emanuel-eckstein/HydroIntellix/Bilder/Platine_verloetet.jpg

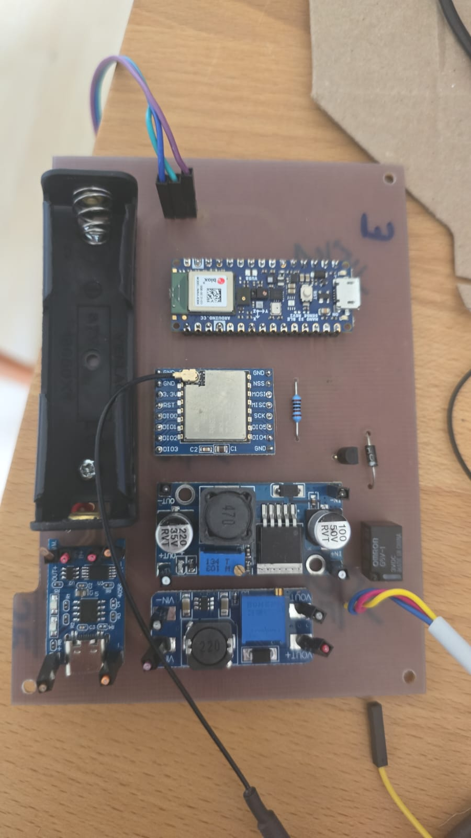
Bilder/Platine_verloetet.jpg
