emanuel-eckstein/HydroIntellix/Bilder/HydroIntellix_im_Erdbeerbeet.jpg

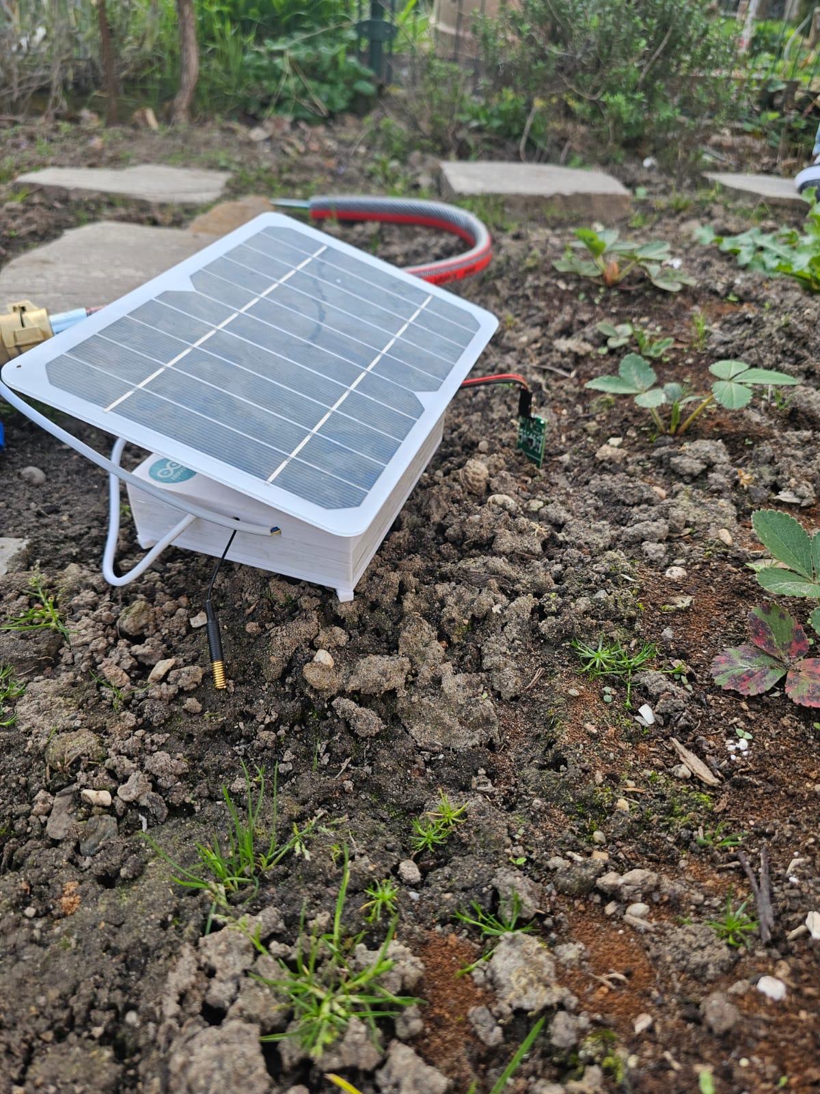
Bilder/HydroIntellix_im_Erdbeerbeet.jpg
