emanuel-eckstein/HydroIntellix/Werkzeugliste.txt

Werkzeugliste

Lötkolben, Dritte Hand, Entlötpumpe, Lötzinn
Zange
Hobby/Cutter-Messer
Multimeter (Spannungs und Widerstandsprüfung)
3D-Drucker
Steckbrückenkabel
Telefonzange
Schraubenzieherset
Dremel (bohren und flexen)
Abisolierzange

optional:
DC Voltage supply
Schrumpfschläuche
