emanuel-eckstein/HydroIntellix/Bilder/HydroIntellix_im_Rasen.jpg

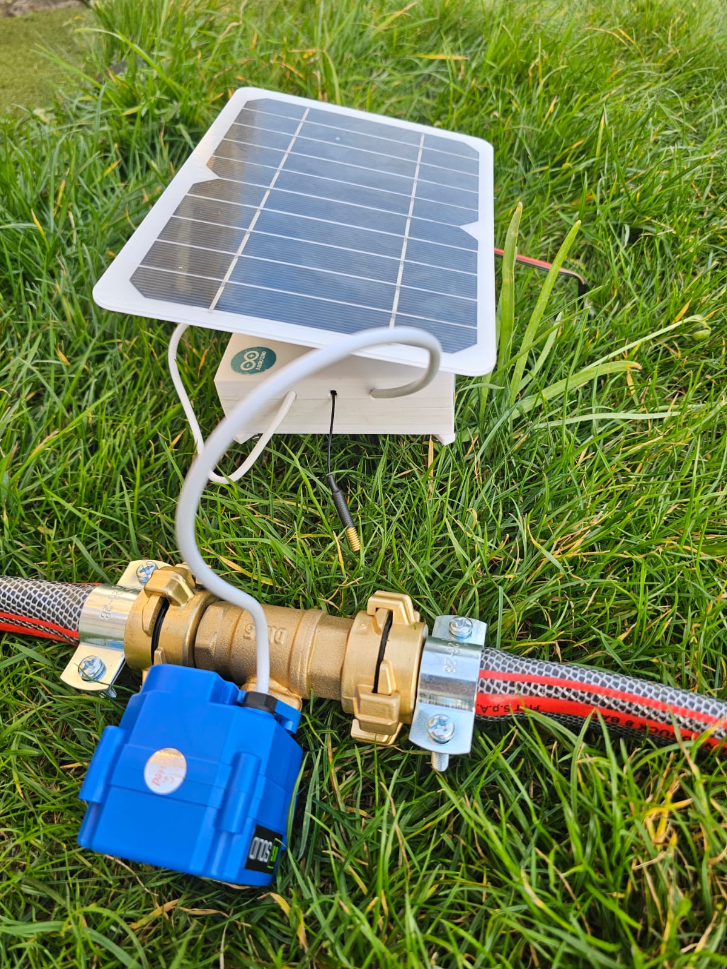
Bilder/HydroIntellix_im_Rasen.jpg
