emanuel-eckstein/HydroIntellix/Leiterplatten/Leiterplatteneditor.png

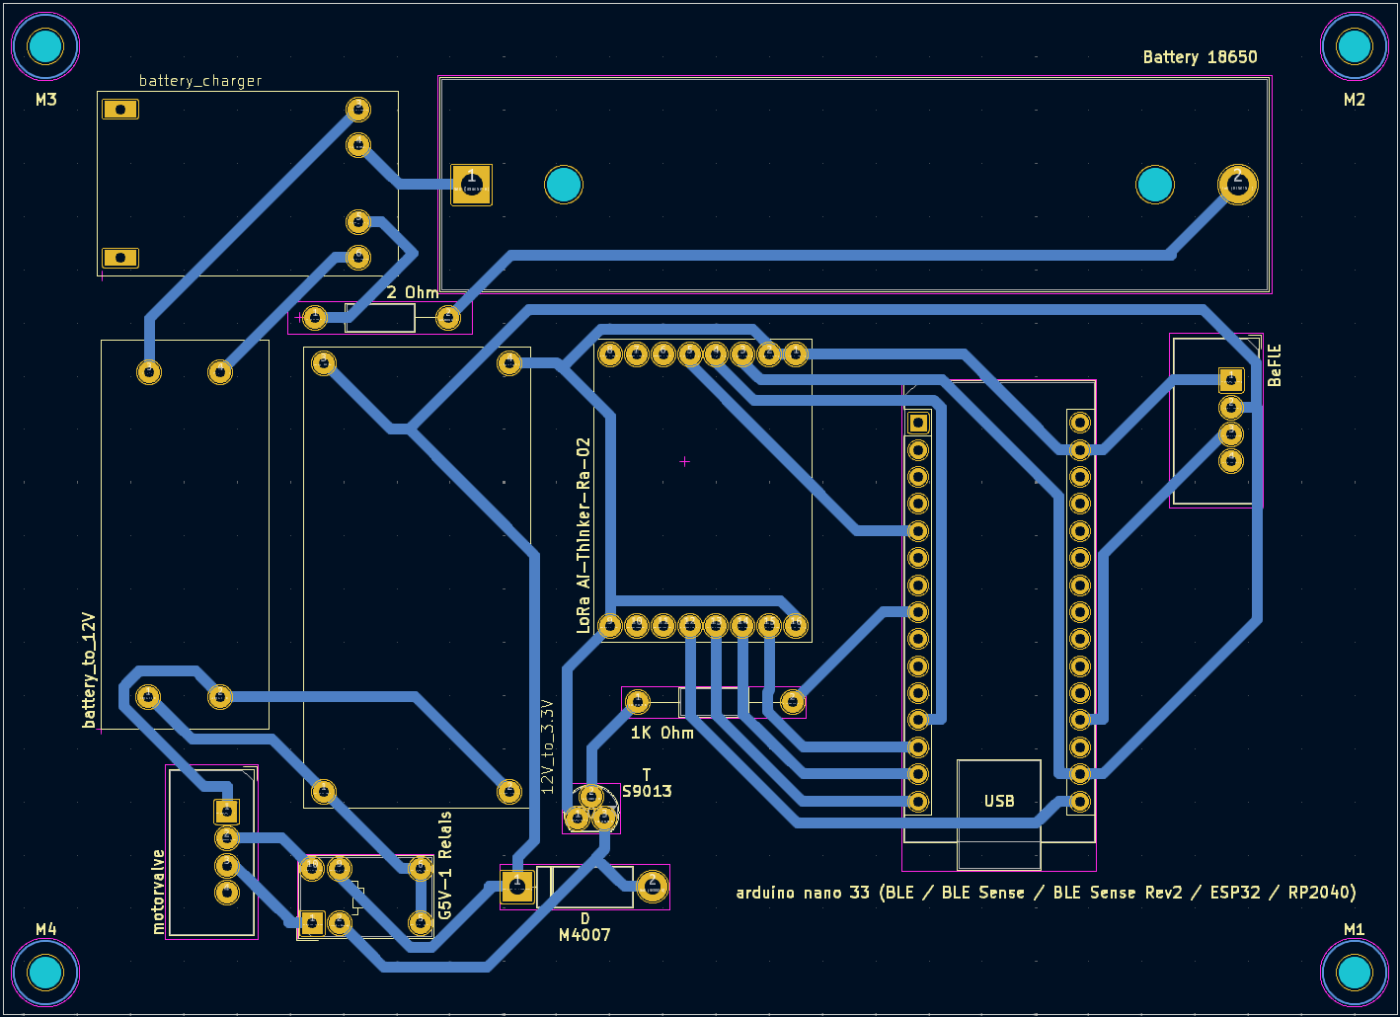
Leiterplatten/Leiterplatteneditor.png
