emanuel-eckstein/HydroIntellix/Leiterplatten/Schaltplan.png

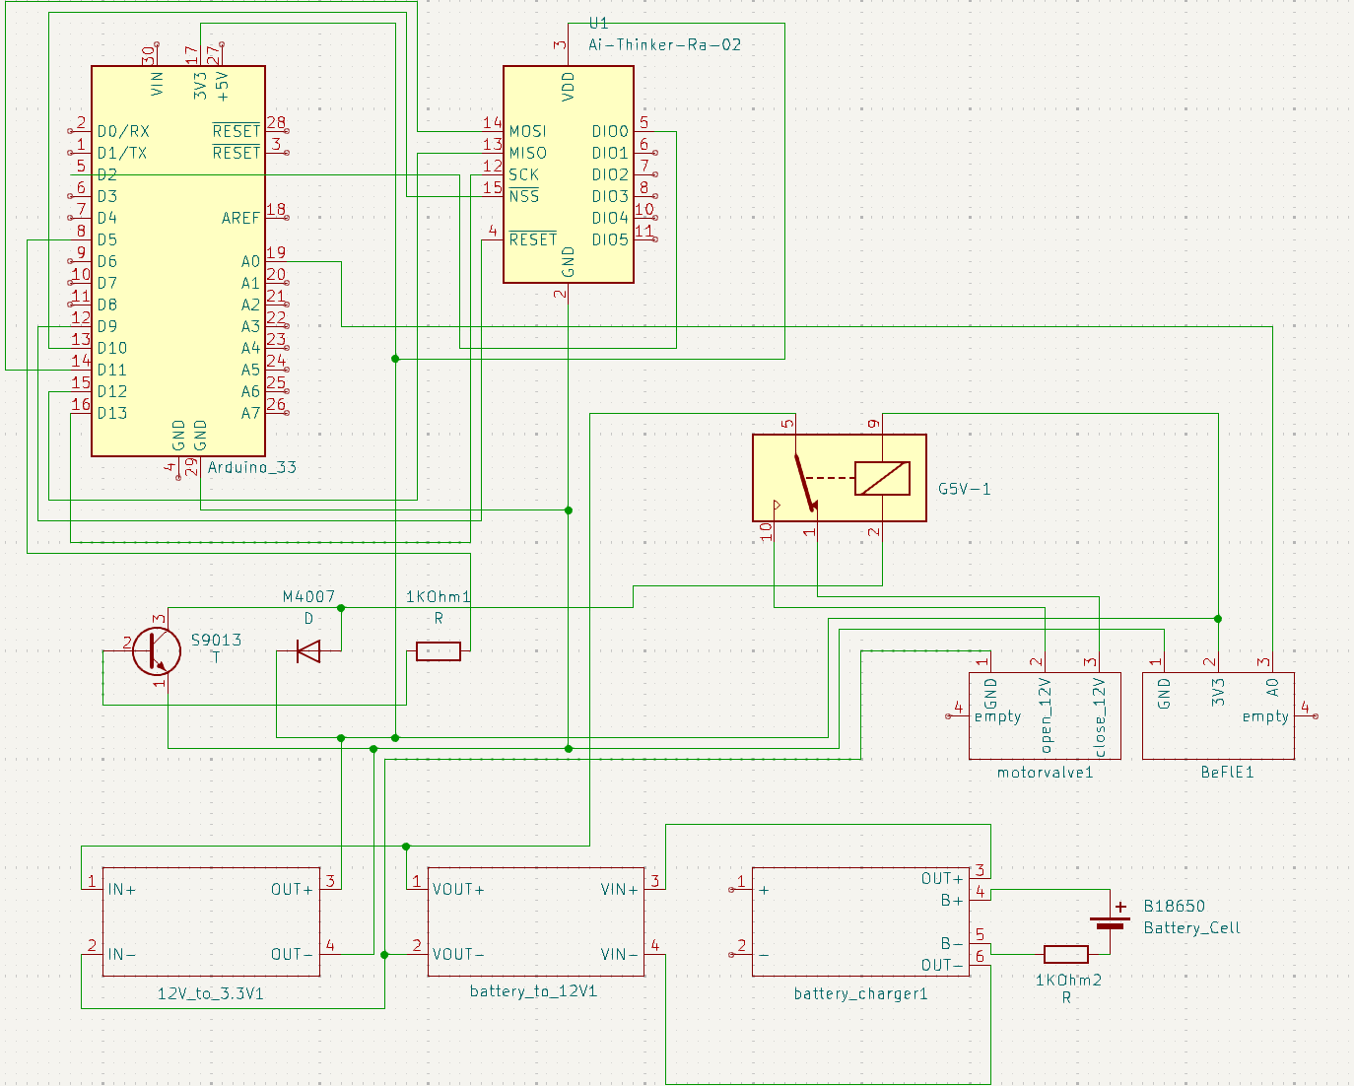
Leiterplatten/Schaltplan.png
