emanuel-eckstein/HydroIntellix/Leiterplatten/Bauteile Leiterplatte.ods

Bauteile | Beschreibung | Spannungbereich | Kommunikationsschnittstelle | Verwendungszweck | Anzahl | Stückpreis (€) | Link
Arduino Nano Arduino Nano 33 BLE Sense Rev2 | Mikrocontroller Board | 5V | USB | Steuer | 1 | 45.47 | https://www.amazon.de/dp/B0BQHXVSGM?psc=1&ref=ppx_yo2ov_dt_b_product_details
SX1278 LoRa 433MHz Ra-02 | Langstrecken - Transceiver | 1.8 - 3.7V (3.3V) | SPI | Drahtlose Kommunikation | 1 | 10.49 | https://www.amazon.de/SX1278-433MHz-Wireless-Spectrum-Transmission/dp/B07RD2JV7Y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
DollaTek 433 MHz Wireless 3dBi IPEX WiFi Windungs Antenne | Antenne 433Mhz |  |  | Signalübertragung | 2 | 1.99 | https://www.amazon.de/DollaTek-Wireless-Fr%C3%BChling-Antenne-Ra-02/dp/B07QWRTN3F
DC-DC Buck Converter 3,2-46V bis 1,25-35V | DC-DC-Step-Down | nach 3.3V |  | Spannungssenkung | 1 | 1.8 | https://www.amazon.de/Yizhet-Stromversorgung-Abw%C3%A4rtswandler-Einstellbares-Abw%C3%A4rtsmodul/dp/B0823P6PW6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
DC-DC Step Up Boost Converter 2V-24V bis 5V-28V | DC-DC-Step-Up | nach 12V |  | Spannungserhöhung | 1 | 0.85 | https://www.amazon.de/gp/product/B0B932BR7V/ref=ppx_yo_dt_b_asin_title_o00_s00?ie=UTF8&psc=1
OMRON G5V-1 Relais | Relais | 3V |  | Schalten elektrischer Lasten | 1 | 0.99 | https://www.reichelt.de/subminiaturrelais-1x-um-125vac-60v-1a-12v-g5v-1-12dc-p28333.html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
BeFlE kapazitiver Bodenfeuchtesensor SoMoSe v2.2 | Kapazitätssensor | 3.3 - 5V | Analog | Bodenfeuchtigkeitsmessung | 1 | 14.49 | https://www.amazon.de/BeFlE-kapazitiver-Bodenfeuchtesensor-SoMoSe-v1-1/dp/B091D6HNM6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
TC4056 Type-C USB 5V 1A 18650 Lithium Battery Charger Module | Laderegler | 4.35 - 6V (5V) |  | Regulierung des Ladevorgangs | 1 | 1.1 | https://www.amazon.de/GTIWUNG-Batteriehalter-Charging-Protection-Functions/dp/B0CGVM55S3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
18650 Batteriehalter mit Kabeln | Batteriehalterung |  |  | Befestigung für Batterien | 1
GOLISI IMR 18650 | 18650 Akku | 3.7V |  | Lithium - Akku | 1 | 9.49
U.S. Solid 1/2" Motorkugelhahn Messing Elektrische Zonenventil | Motorisierter Kugelhahn | 9 - 24V |  | Ventilsteuerung | 1 | 37 | https://www.amazon.de/U-S-Solid-Motorkugelhahn-Elektrische-Zonenventil/dp/B07CWMRZXK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
S9013 | NPN-Transistor |  |  | Elektronische Schaltung | 1 | 0.01
Widerstand 1 kOhm | Widerstand(1kOhm) |  |  | Elektrischer Widerstand | 1 | 0.01
Widerstand 2 Ohm | Widerstand(1kOhm) |  |  | Elektrischer Widerstand | 1 | 0.01
M4007 | Diode |  |  | Elektrionische Schaltung | 1 | 0.01
Irishom Solarpanel mit USB Anschluss | Solarzelle | 5V | USB | Umwandlung vom Sonnelicht | 1 | 13.79 | https://www.amazon.de/Irishom-Solarpanel-Anschluss-Ladeger%C3%A4t-Unterwegs/dp/B09W5QJQ5Q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
 |  |  |  |  |  | 137.5
