emanuel-eckstein/HydroIntellix/Gehaeuse/Hardwareliste.ods

Hardware | Stück | Stückpreis(€) | Summe(€)
Gewindestange M6 | 1 | 1.89 | 1.89
Rohrschelle | 1 | 3.09 | 3.09
Schnellkupplung mit Schlauchstück 3/4" | 2 | 4.99 | 9.98
Schnellkupplung mit Gewindestück 1/2'' | 2 | 5.29 | 10.58
Gewindedichtband | 0.1 | 3.29 | 0.33
Sechskantmutter M6 | 3 | 0.22 | 0.66
Sechskantmutter M3 | 6 | 0.04 | 0.25
Schrauben 3,0 x 20 | 6 | 0.08 | 0.48
 |  |  | 27.26
