emanuel-eckstein/HydroIntellix/Gehaeuse/baseplate.stl

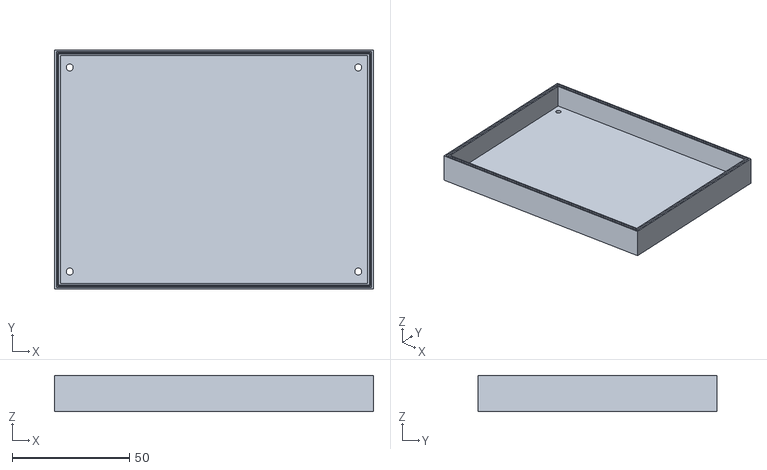
[picture p14: CAD file, 2024-04-01]
Gehaeuse/baseplate.stl
136.0 x 102.0 x 15.5
