emanuel-eckstein/HydroIntellix/Gehaeuse/topplate.stl

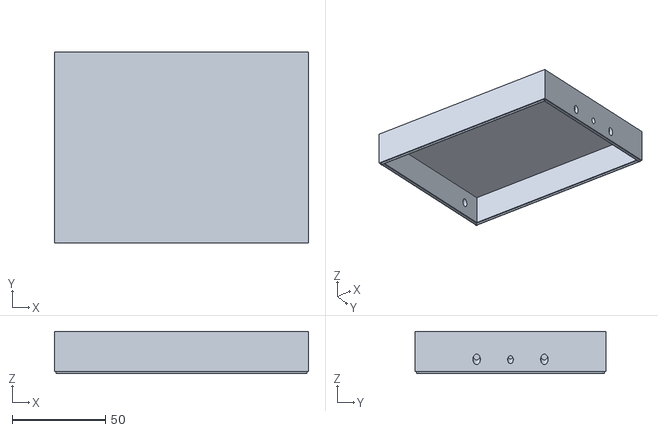
[picture p15: CAD file, 2024-04-01]
Gehaeuse/topplate.stl
136.0 x 102.0 x 22.5
