emanuel-eckstein/HydroIntellix/Gehaeuse/groundbrace.stl

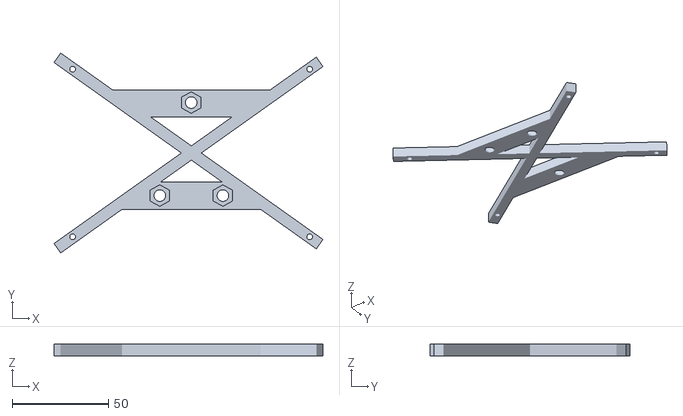
[picture p16: CAD file, 2024-04-01]
Gehaeuse/groundbrace.stl
139.6 x 103.7 x 6.00
