emanuel-eckstein/HydroIntellix/Gehaeuse/panelholder.stl

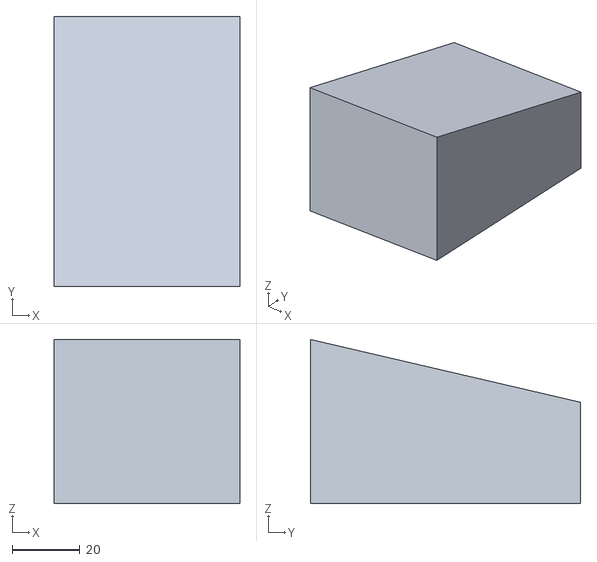
[picture p17: CAD file, 2024-04-01]
Gehaeuse/panelholder.stl
55.0 x 80.0 x 48.6
